KileyDA/stm32-smart-depot-safety-monitoring/images/pinout-reference/README.md

# Pinout Reference Images

This folder contains board pinout diagrams used to map Arduino header pins to STM32 microcontroller pins.
