KileyDA/stm32-smart-depot-safety-monitoring/images/circuit-diagrams/README.md

# Circuit Diagram Images

This folder contains exported circuit diagram images used in the hardware documentation.
