KileyDA/stm32-smart-depot-safety-monitoring/images/cubemx-configuration/README.md

# CubeMX Configuration Screenshots

This folder contains STM32CubeMX configuration screenshots used in the project documentation.
