KileyDA/stm32-smart-depot-safety-monitoring/images/hardware-setup/README.md

# Hardware Setup Images

This folder contains photos of the physical STM32 hardware setup and breadboard circuits.
