KileyDA/stm32-smart-depot-safety-monitoring/images/test-results/README.md

# Test Result Images

This folder contains screenshots of firmware test outputs and serial monitor results.
