KileyDA/stm32-smart-depot-safety-monitoring/images/kicad-debugging/custom-symbol-library/README.md

Contains all the screenshots for the error obtained while trying to create a custom symbol to be used in creating the PIR circuit schematic
