KileyDA/stm32-smart-depot-safety-monitoring/firmware/bare-metal-stm32f446re/Src/main.c

/**
 ******************************************************************************
 * @file           : main.c
 * @author         : Kelly Dianga
 * @brief          : Main program body
 ******************************************************************************
 * @attention
 *
 * Copyright (c) 2026 STMicroelectronics.
 * All rights reserved.
 *
 * This software is licensed under terms that can be found in the LICENSE file
 * in the root directory of this software component.
 * If no LICENSE file comes with this software, it is provided AS-IS.
 *
 ******************************************************************************
 */

#include <stdint.h>

#if !defined(__SOFT_FP__) && defined(__ARM_FP)
  #warning "FPU is not initialized, but the project is compiling for an FPU. Please initialize the FPU before use."
#endif
/* ========================
   Base addresses
   ======================== */
#define PERIPH_BASE   			  		(0x40000000UL)

#define AHB1_OFFSET	  			  		(0x00020000UL)
#define AHB1_BASE	    		  		(PERIPH_BASE + AHB1_OFFSET)

#define APB1_OFFSET				  		(0x00000000UL)
#define APB1_BASE				  		(PERIPH_BASE + APB1_OFFSET)

#define APB2_OFFSET				  		(0x00010000UL)
#define APB2_BASE				  		(PERIPH_BASE + APB2_OFFSET)

/* =========================
   Peripheral base addresses
   ========================= */
#define GPIOA_OFFSET    		  		(0x00000000UL)
#define GPIOA_BASE	  	    	  		(AHB1_BASE + GPIOA_OFFSET)

#define GPIOB_OFFSET			  		(0x00000400UL)
#define GPIOB_BASE				  		(AHB1_BASE + GPIOB_OFFSET)

#define RCC_OFFSET	    		  		(0x00003800UL)
#define RCC_BASE  	    		  		(AHB1_BASE + RCC_OFFSET)

#define TIM3_OFFSET				  		(0x00000400UL)
#define TIM3_BASE				  		(APB1_BASE + TIM3_OFFSET)

#define ADC1_OFFSET				  		(0x00002000UL)
#define ADC1_BASE				  		(APB2_BASE + ADC1_OFFSET)

#define DMA2_OFFSET						(0x00006400UL)
#define DMA2_BASE						(AHB1_BASE + DMA2_OFFSET)
/* =========================
   Register Access Helper
   ========================= */
#define REG32(addr)         	  		(*(volatile uint32_t *)(addr))

/* =========================
   RCC Register Offsets
   ========================= */
#define RCC_AHB1ENR_OFFSET        		(0x30UL)
#define RCC_APB1ENR_OFFSET        		(0x40UL)
#define RCC_APB2ENR_OFFSET        		(0x44UL)

/* =========================
   RCC Register Definitions
   ========================= */
#define RCC_AHB1ENR               		REG32(RCC_BASE + RCC_AHB1ENR_OFFSET)
#define RCC_APB1ENR               		REG32(RCC_BASE + RCC_APB1ENR_OFFSET)
#define RCC_APB2ENR               		REG32(RCC_BASE + RCC_APB2ENR_OFFSET)

/* =========================
   GPIO Register Offsets
   ========================= */
#define GPIO_MODER_OFFSET         		(0x00UL)
#define GPIO_PUPDR_OFFSET				(0x0CUL)
#define GPIO_ODR_OFFSET           		(0x14UL)
#define GPIO_IDR_OFFSET					(0x10UL)
#define GPIO_AFRL_OFFSET          		(0x20UL)

/* =========================
   GPIO Register Definitions
   ========================= */
#define GPIOA_MODER               		REG32(GPIOA_BASE + GPIO_MODER_OFFSET)
#define GPIOA_PUPDR						REG32(GPIOA_BASE + GPIO_PUPDR_OFFSET)
#define GPIOA_ODR                 		REG32(GPIOA_BASE + GPIO_ODR_OFFSET)
#define GPIOA_IDR  						REG32(GPIOA_BASE + GPIO_IDR_OFFSET)

#define GPIOB_MODER               		REG32(GPIOB_BASE + GPIO_MODER_OFFSET)
#define GPIOB_AFRL                		REG32(GPIOB_BASE + GPIO_AFRL_OFFSET)


/* =========================
   TIM3 Register Offsets
   ========================= */
#define TIM3_CR1_OFFSET          		(0x00UL)
#define TIM3_EGR_OFFSET		     		(0x14UL)
#define TIM3_CCMR1_OFFSET	     		(0x18UL)
#define TIM3_CCER_OFFSET	     		(0x20UL)
#define TIM3_CNT_OFFSET          		(0x24UL)
#define TIM3_PSC_OFFSET		     		(0x28UL)
#define TIM3_ARR_OFFSET		     		(0x2CUL)
#define TIM3_CCR1_OFFSET	     		(0x34UL)


/* =========================
   TIM3 Register Definitions
   ========================= */
#define TIM3_CR1                 		REG32(TIM3_BASE + TIM3_CR1_OFFSET)
#define TIM3_EGR                 		REG32(TIM3_BASE + TIM3_EGR_OFFSET)
#define TIM3_CCMR1               		REG32(TIM3_BASE + TIM3_CCMR1_OFFSET)
#define TIM3_CCER                		REG32(TIM3_BASE + TIM3_CCER_OFFSET)
#define TIM3_CNT                 		REG32(TIM3_BASE + TIM3_CNT_OFFSET)
#define TIM3_PSC                 		REG32(TIM3_BASE + TIM3_PSC_OFFSET)
#define TIM3_ARR                 		REG32(TIM3_BASE + TIM3_ARR_OFFSET)
#define TIM3_CCR1                		REG32(TIM3_BASE + TIM3_CCR1_OFFSET)

/* =========================
   ADC1 Register Offsets
   ========================= */
#define ADC1_SR_OFFSET          		(0x00UL)
#define ADC1_CR1_OFFSET		    		(0x04UL)
#define ADC1_CR2_OFFSET         		(0x08UL)
#define ADC1_SMPR2_OFFSET       		(0x10UL)
#define ADC1_SQR1_OFFSET	    		(0x2CUL)
#define ADC1_SQR3_OFFSET	    		(0x34UL)
#define ADC1_DR_OFFSET          		(0x4CUL)

/* =========================
   ADC1 Register Definitions
   ========================= */
#define ADC1_SR       		    		 REG32(ADC1_BASE + ADC1_SR_OFFSET)
#define ADC1_CR1		  	    		 REG32(ADC1_BASE + ADC1_CR1_OFFSET)
#define ADC1_CR2       		    		 REG32(ADC1_BASE + ADC1_CR2_OFFSET)
#define ADC1_SMPR2     		    		 REG32(ADC1_BASE + ADC1_SMPR2_OFFSET)
#define ADC1_SQR1	  		    		 REG32(ADC1_BASE + ADC1_SQR1_OFFSET)
#define ADC1_SQR3	  		    		 REG32(ADC1_BASE + ADC1_SQR3_OFFSET)
#define ADC1_DR       		   			 REG32(ADC1_BASE + ADC1_DR_OFFSET)

/* =========================
   DMA Register Offsets
   ========================= */
#define DMA_LIFCR_OFFSET				  (0x008UL)
#define DMA_S0CR_OFFSET 				  (0x010UL)
#define DMA_S0NDTR_OFFSET                 (0x014UL)
#define DMA_S0PAR_OFFSET				  (0x018UL)
#define DMA_S0M0AR_OFFSET				  (0x01CUL)

/* =========================
   DMA2 Register Definitions
   ========================= */
#define DMA2_LIFCR						  REG32(DMA2_BASE + DMA_LIFCR_OFFSET)
#define DMA2_S0CR						  REG32(DMA2_BASE + DMA_S0CR_OFFSET)
#define DMA2_S0NDTR						  REG32(DMA2_BASE + DMA_S0NDTR_OFFSET)
#define DMA2_S0PAR						  REG32(DMA2_BASE + DMA_S0PAR_OFFSET)
#define DMA2_S0M0AR						  REG32(DMA2_BASE + DMA_S0M0AR_OFFSET)

/* =========================
   RCC Peripheral Enable Bits
   ========================= */
#define GPIOAEN				   			 (1U << 0)
#define GPIOBEN				   			 (1U << 1)
#define TIM3EN				   			 (1U << 1)
#define ADC1EN				   			 (1U << 8)
#define DMA2EN						     (1U << 22)
/* =========================
   TIM3 Control Bits
   ========================= */
#define TIM_CR1_CEN     	   			 (1U << 0)
#define TIM_CR1_ARPE     	   			 (1U << 7)

/* =========================
   TIM3 Event Generation Bits
   ========================= */
#define TIM_EGR_UG             			 (1U << 0)    // Update generation


/* =========================
   TIM3 Capture/Compare Mode Bits
   ========================= */
#define TIM_CCMR1_OC1PE       			 (1U << 3)    // Output compare 1 preload enable
#define TIM_CCMR1_OC1M_PWM1   			 (0x6U << 4)  // PWM mode 1
#define TIM_CCMR1_OC1M_MASK   			 (0x7U << 4)  // OC1M bit mask
#define TIM_CCMR1_CC1S_MASK   			 (0x3U << 0)  // Channel 1 selection mask

/* =========================
   TIM3 PWM Output Bits
   ========================= */
#define TIM_CCER_CC1E   	  			 (1U << 0)

/* =========================
   GPIOB PB4 TIM3_CH1 Pin Mapping
   ========================= */
#define PB4_MODE_BIT0         			 (1U << 8)
#define PB4_MODE_BIT1         			 (1U << 9)

#define PB4_AFRL_SHIFT        			 (16U)
#define GPIO_AF2_TIM3         		 	 (0x2U)
#define GPIO_AFR_MASK         			 (0xFU)

/* =========================
   GPIOA PA0 Analog Pin Mapping
   ========================= */
#define PA0_MODE_BIT0         			 (1U << 0)
#define PA0_MODE_BIT1         			 (1U << 1)

#define ADC_SMPR2_SMP0_SHIFT  			 (0U)
#define ADC_SMPR2_SAMPLE_MASK 			 (0x7U)
#define ADC_SAMPLE_84_CYCLES  			 (0x4U)

#define ADC_SQR3_SQ1_SHIFT    			 (0U)
#define ADC_SQR3_SQ1_MASK     			 (0x1FU)
#define ADC_CHANNEL_0 		  			 (0U)

#define ADC_SQR1_LENGTH_SHIFT  			 (20U)
#define ADC_SQR1_LENGTH_MASK  			 (0xFU)
#define ADC_SEQUENCE_LENGTH_1_CONVERSION (0U)

/* =========================
   ADC Control and Status Bits
   ========================= */
#define ADC_CR2_ADON                     (1U << 0)
#define ADC_CR2_SWSTART         		 (1U << 30)
#define ADC_CR2_DMA 					 (1U << 8)
#define ADC_CR2_DDS 					 (1U << 9)
#define ADC_CR2_CONT 					 (1U << 1)
#define ADC_SR_EOC              		 (1U << 1)


/* =========================
   DMA Stream Control Bits
   ========================= */
#define DMA_SCR_EN						 (1U << 0)
#define DMA_SCR_CHSEL_MASK               (0x7U << 25)
#define DMA_SCR_DIR_MASK				 (0x3U << 6)
#define DMA_SCR_PSIZE_MASK   			 (0x3U << 11)
#define DMA_SCR_MSIZE_MASK   			 (0x3U << 13)
#define DMA_SCR_CIRC         			 (1U << 8)

#define DMA_SCR_PSIZE_HALFWORD      	 (1U << 11)
#define DMA_SCR_MSIZE_HALFWORD      	 (1U << 13)

/* =========================
   DMA Stream 0 Flag Clear Bits
   ========================= */
#define DMA_LIFCR_CLEAR_STREAM0			 ((1U<<0)|(1U<<2)|(1U<<3)|(1U<<4)|(1U<<5))

/* =========================
   Generic GPIO helpers
   ========================= */
#define GPIO_2BIT_FIELD_WIDTH      (2U)
#define GPIO_2BIT_MASK             (0x3U)

#define GPIO_PIN_SHIFT(pin)        ((pin) * GPIO_2BIT_FIELD_WIDTH)
#define GPIO_PIN_2BIT_MASK(pin)    (GPIO_2BIT_MASK << GPIO_PIN_SHIFT(pin))
#define GPIO_PIN_MASK(pin)         (1U << (pin))

#define GPIO_MODE_INPUT            (0x0U)
#define GPIO_MODE_OUTPUT           (0x1U)
#define GPIO_MODE_ALTERNATE        (0x2U)
#define GPIO_MODE_ANALOG           (0x3U)

#define GPIO_PUPD_NONE             (0x0U)
#define GPIO_PUPD_PULLUP           (0x1U)
#define GPIO_PUPD_PULLDOWN         (0x2U)

#define GPIO_SET_MODE(GPIOx_MODER, pin, mode)                  \
    do {                                                        \
        (GPIOx_MODER) &= ~GPIO_PIN_2BIT_MASK(pin);              \
        (GPIOx_MODER) |=  (((mode) & GPIO_2BIT_MASK)            \
                           << GPIO_PIN_SHIFT(pin));             \
    } while (0)

#define GPIO_SET_PUPD(GPIOx_PUPDR, pin, pupd)                  \
    do {                                                        \
        (GPIOx_PUPDR) &= ~GPIO_PIN_2BIT_MASK(pin);              \
        (GPIOx_PUPDR) |=  (((pupd) & GPIO_2BIT_MASK)            \
                           << GPIO_PIN_SHIFT(pin));             \
    } while (0)

/* =========================
   Pin Numbers
   ========================= */
#define LIGHT_DETECTOR_PIN         (0U)  // PA0
#define PIR_SENSOR_PIN             (1U)  // PA1
#define SECURITY_LIGHT_PIN         (4U)  // PB4
#define WARNING_LED_PIN            (8U)  // PA8

/* =========================
   Pin Masks
   ========================= */
#define LIGHT_DETECTOR             GPIO_PIN_MASK(LIGHT_DETECTOR_PIN)
#define PIR_SENSOR                 GPIO_PIN_MASK(PIR_SENSOR_PIN)
#define SECURITY_LIGHT             GPIO_PIN_MASK(SECURITY_LIGHT_PIN)
#define WARNING_LED                GPIO_PIN_MASK(WARNING_LED_PIN)

#define NIGHT_THRESHOLD 1200

volatile uint16_t adc_dma_value = 0;

void adc1_pa0_init(void){
	/*Enable clock for PA0*/
	RCC_AHB1ENR |= GPIOAEN;

	/*Configure PA0 as analogue*/
	GPIO_SET_MODE(GPIOA_MODER, LIGHT_DETECTOR_PIN, GPIO_MODE_ANALOG);

	/*Enable ADC peripheral clock*/
	RCC_APB2ENR |= ADC1EN;

	/*Set Sequence Length to 1 */
	ADC1_SQR1 &= ~(ADC_SQR1_LENGTH_MASK << ADC_SQR1_LENGTH_SHIFT);
	ADC1_SQR1 |= (ADC_SEQUENCE_LENGTH_1_CONVERSION << ADC_SQR1_LENGTH_SHIFT);

	/* Select ADC channel 0 as the first regular conversion */
	ADC1_SQR3 &= ~(ADC_SQR3_SQ1_MASK << ADC_SQR3_SQ1_SHIFT);
	ADC1_SQR3 |= (ADC_CHANNEL_0 << ADC_SQR3_SQ1_SHIFT);

	/*Set Sample time */
	ADC1_SMPR2 &= ~(ADC_SMPR2_SAMPLE_MASK << ADC_SMPR2_SMP0_SHIFT);
	ADC1_SMPR2 |= (ADC_SAMPLE_84_CYCLES << ADC_SMPR2_SMP0_SHIFT);

	/*Enable ADC1 */
	ADC1_CR2 |= ADC_CR2_ADON;

}

void adc1_start_conversion(void){
	/*1. Start ADC Conversion */
	ADC1_CR2 |=  ADC_CR2_SWSTART;
}

void adc1_dma_init(void){
	/* 1. Enable DMA2 clock*/
	RCC_AHB1ENR |= DMA2EN;

	/* 2. Disable DMA2 Stream 0 before configuring it.*/
	DMA2_S0CR &= ~DMA_SCR_EN;

	/* 3. Wait until DMA stream is fully disabled */
	while (DMA2_S0CR & DMA_SCR_EN) {}

	/* 4. Clear any pending flags for DMA2 Stream0 */
	DMA2_LIFCR |= DMA_LIFCR_CLEAR_STREAM0;

	/* 5. Set peripheral address: adc1 data register */
	DMA2_S0PAR = (uint32_t)&ADC1_DR;

	/* 6. Set memory address: variable where ADC result will be stored */
	DMA2_S0M0AR	= (uint32_t)&adc_dma_value;

	/* 7. Set the number of data items to transfer */
	DMA2_S0NDTR = 1;

	/* 8. Select DMA channel 0 for ADC1 */
	DMA2_S0CR &= ~DMA_SCR_CHSEL_MASK;

	/* 9. Set direction: peripheral-to-memory */
	DMA2_S0CR &= ~DMA_SCR_DIR_MASK;

	/* 10. Set peripheral data size to half-word, because ADC result is 12-bit */
	DMA2_S0CR &= ~DMA_SCR_PSIZE_MASK;
	DMA2_S0CR |= DMA_SCR_PSIZE_HALFWORD;

	/* 11. Set memory data size to half-word */
	DMA2_S0CR &= ~DMA_SCR_MSIZE_MASK;
	DMA2_S0CR |= DMA_SCR_MSIZE_HALFWORD;

	/* 12. Enable circular mode so that the value keeps updating*/
	DMA2_S0CR |= DMA_SCR_CIRC;

	/* 13. Enable DMA mode in ADC1*/
	ADC1_CR2 |= ADC_CR2_DMA;

	/* 14. Keep DMA requests active after each conversion*/
	ADC1_CR2 |= ADC_CR2_DDS;

	/* 15. Enable continous conversion mode*/
	ADC1_CR2 |= ADC_CR2_CONT;

	/* 16. Enable DMA2 Stream 0*/
	DMA2_S0CR |= DMA_SCR_EN;
}

void security_light_pwm_init(void)
{
    /* 1. Enable GPIOB clock */
    RCC_AHB1ENR |= GPIOBEN;

    /* 2. Configure PB4 as alternate function mode */
    GPIO_SET_MODE(GPIOB_MODER, SECURITY_LIGHT_PIN, GPIO_MODE_ALTERNATE);

    /* 3. Select AF2 for PB4: PB4 -> TIM3_CH1 */
    GPIOB_AFRL &= ~(GPIO_AFR_MASK << PB4_AFRL_SHIFT);  // Clear PB4 AF bits
    GPIOB_AFRL |=  (GPIO_AF2_TIM3 << PB4_AFRL_SHIFT);  // Set AF2

    /* 4. Enable TIM3 clock */
    RCC_APB1ENR |= TIM3EN;

    /* 5. Set TIM3 prescaler */
    TIM3_PSC = 160 - 1;

    /* 6. Set PWM period */
    TIM3_ARR = 100 - 1;

    /* 7. Set duty cycle */
    TIM3_CCR1 = 0;  // Security light off

    /* 8. Configure Channel 1 as PWM mode 1 */
    TIM3_CCMR1 &= ~TIM_CCMR1_CC1S_MASK;  // CC1S = 00, output mode
    TIM3_CCMR1 &= ~TIM_CCMR1_OC1M_MASK;  // Clear OC1M bits
    TIM3_CCMR1 |=  TIM_CCMR1_OC1M_PWM1;  // Set OC1M = 110, PWM mode 1

    /* 9. Enable preload for Channel 1 */
    TIM3_CCMR1 |= TIM_CCMR1_OC1PE;

    /* 10. Enable TIM3 Channel 1 output */
    TIM3_CCER |= TIM_CCER_CC1E;

    /* 11. Enable auto-reload preload */
    TIM3_CR1 |= TIM_CR1_ARPE;

    /* 12. Generate update event */
    TIM3_EGR |= TIM_EGR_UG;

    /* 13. Reset counter */
    TIM3_CNT = 0;

    /* 14. Start TIM3 */
    TIM3_CR1 |= TIM_CR1_CEN;
}

void warning_led_init(void){
    /* Enable GPIOA clock for warning LED */
    RCC_AHB1ENR |= GPIOAEN;

    /* Configure PA8 as output mode */
    GPIO_SET_MODE(GPIOA_MODER, WARNING_LED_PIN, GPIO_MODE_OUTPUT);
}

void pir_sensor_init(void)
{
    /* 1. Enable GPIOA clock */
    RCC_AHB1ENR |= GPIOAEN;

    /* 2. Configure PA1 as input mode */
    GPIO_SET_MODE(GPIOA_MODER, PIR_SENSOR_PIN, GPIO_MODE_INPUT);

    /* 3. No pull-up or pull-down for first test */
    GPIO_SET_PUPD(GPIOA_PUPDR, PIR_SENSOR_PIN, GPIO_PUPD_NONE);
}

uint8_t pir_motion_detected(void)
{
    return (GPIOA_IDR & PIR_SENSOR) != 0;
}

int main(void)
{

	security_light_pwm_init();
    warning_led_init();
    adc1_pa0_init();
    adc1_dma_init();
    adc1_start_conversion();
    pir_sensor_init();

    while (1)
    {

    	if(adc_dma_value < NIGHT_THRESHOLD){
    		/* Dark environment: keep security light dimmed - 50% brightness */
    		TIM3_CCR1 = 50;

    		if(pir_motion_detected()){
    			 /* Dark + motion detected: increase brightness and turn on warning LED */
    			TIM3_CCR1 = 100;
    			GPIOA_ODR |= WARNING_LED;
    		}
    		else{
    			 /* Dark + no motion: keep light dimmed and warning LED off */
    			TIM3_CCR1 = 50;
    			GPIOA_ODR &= ~WARNING_LED;
    		}
    	}
    	else{
    		 /* Bright environment: security light and warning LED off */
    		TIM3_CCR1 = 0;
    		GPIOA_ODR &= ~WARNING_LED;
    	}
    }
}
