KileyDA/stm32-smart-depot-safety-monitoring/(commit log)

2026-06-18 docs: add documentation for LDR voltage divider circuit
    Document the LDR voltage divider circuit for light detection, including purpose, components, pin connections, and test results.
2026-06-18 docs: create circuit diagram images folder
2026-06-18 docs: add LDR voltage divider diagram
2026-06-18 docs: move LDR documentation into circuit diagrams folder
2026-06-18 docs: add LDR physical circuit image
2026-06-18 docs: revise LDR voltage divider documentation with images
    Updated image paths and added CubeMX configuration screenshots for the LDR voltage divider circuit documentation.
2026-06-18 docs: add PIR Motion Sensor Circuit Documentation
    This document outlines the circuit design and functionality of the PIR motion sensor used in the Smart Depot Safety and Access Monitoring System, including components, pin connections, and firmware testing.
2026-06-18 docs: add PIR motion sensor test output screenshot
2026-06-18 docs: add CubeMX configuration screenshot for PIR sensor
    Added CubeMX configuration screenshot for PIR sensor input.
2026-06-19 docs: add security light PWM CubeMX screenshot
2026-06-19 docs: add warning LED CubeMX screenshot
2026-06-19 docs: add security and warning LED documentation
    Added documentation for the security light and warning LED circuits, including purpose, components, pin mapping, connections, and configuration details.
2026-06-24 docs: add active buzzer transistor driver circuit documentation
    Document the active buzzer transistor driver circuit for the Smart Depot Safety and Access Monitoring System, including purpose, components, circuit concept, and testing procedures.
2026-07-01 docs: add documentation for reset/acknowledge button circuit
    This document outlines the circuit design and functionality of the reset/acknowledge button for the Smart Depot Safety and Access Monitoring System, including its purpose, components, logic, and firmware testing.
2026-07-02 docs: add LDR voltage divider schematic
2026-07-02 chore: delete images/circuit-diagrams/01-ldr-voltage-divider.png
2026-07-02 chore: change LDR voltage divider image to schematic
    Updated the image to show the schematic of the LDR voltage divider.
2026-07-02 docs: add README with error screenshots for KiCad
    Contains all the screenshots for the error obtained while trying to create a custom symbol to be used in creating the PIR circuit schematic
2026-07-02 docs: add screenshots of errors encountered in KiCad Symbol Editor
2026-07-02 docs: add screenshot of cleared filter KiCad
2026-07-02 debugging: add KiCad symbol library troubleshooting notes
2026-07-03 docs: add PIR motion sensor schematic
2026-07-03 docs: add PIR motion sensor schematic
    Added schematic diagram for PIR motion sensor.
2026-07-03 docs: add security and warning led schematic
2026-07-03 docs: add LED schematic to security and warning LEDs documentation
    Added schematic image for security and warning LEDs.
2026-07-03 docs: add active buzzer transistor driver schematic
2026-07-03 chore: delete images/circuit-diagrams/04-active-buzzer-transistor-driver-schematic.png
2026-07-03 docs: upload correct active buzzer transistor driver schematic
2026-07-03 docs: add circuit schematic for active buzzer driver
    Added schematic image for active buzzer transistor driver circuit.
2026-07-03 docs: add reset/acknowledge button schematic
2026-07-03 docs: add circuit schematic for reset/acknowledge button
    Added a circuit schematic for the reset/acknowledge button.
2026-07-06 chore: rename circuit documentation folder
2026-07-06 docs: add folder for storing bare metal documents
    This README explains the bare-metal implementation for STM32F446RE, focusing on register-level programming without HAL functions.
2026-07-06 docs: add learning notes on RCC and clock gating
    This document provides an overview of RCC, AHB, and peripheral clock gating in STM32 microcontrollers, explaining the importance of clock signals for peripheral operation and detailing how to enable clocks for various peripherals.
2026-07-11 docs: add debugging notes for LED register assignment error
    Documented debugging notes for LED register-level code error related to assignment. Included explanation of the error, correct macro definition, and steps to resolve build issues in STM32CubeIDE.
2026-07-15 firmware: add bare-metal STM32CubeIDE project files
    Add source, startup, linker, launch, and project files for the STM32F446RE bare-metal firmware.
2026-07-15 chore: add gitignore for STM32CubeIDE build files
    Add .gitignore to exclude build artifacts and debug files.
2026-07-15 firmware: add .project file for STM32F446RE project
2026-07-15 firmware: add .cproject file for STM32F446RE project
2026-07-15 docs: add TIM3 PWM implementation notes
    This document explains the implementation of PWM for controlling a security light using TIM3 on the STM32F446RE. It covers the purpose, configuration, and setup sequence for using PWM instead of standard GPIO output.
2026-07-16 firmware: configure TIM3 PWM for security light
2026-07-16 docs: update TIM3 PWM implementation notes
    Updated the documentation to clarify the use of memory-mapped register access, improved readability with macros, and refined the setup sequence for configuring TIM3 for PWM output.
2026-07-22 docs: add ADC1 PA0 Light Detector Implementation notes
    This note details the ADC setup for reading a light detector input using ADC1 on the STM32F446RE. It covers the purpose, pin configuration, register access, initialization sequence, and integration with a security light PWM.
2026-07-22 firmware: add ADC light detection to main
    Add ADC1 PA0 setup and light threshold logic to control the security light PWM based on the LDR reading.
2026-07-27 docs: add DMA1 ADC light detector implementation Document
    Added documentation for implementing DMA with ADC1 for automatic light detection. The notes cover system context, DMA initialization, and the main flow of the program.
2026-07-27 firmware: add ADC DMA support for light detection
    Add DMA2 Stream 0 setup for ADC1 PA0 readings, enabling continuous light sensor updates through adc_dma_value and using the value to control the TIM3 PWM security light.
2026-08-17 firmware: add PIR motion detection logic
    Add PA1 PIR sensor input setup and motion detection logic. The system now uses the PIR reading together with the ADC DMA light value to control the TIM3 PWM security light: dim brightness when it is dark, full brightness when motion is detected, and off when the environment is bright.
2026-11-11 firmware: add USART2 telemetry and periodic status reporting
    Configure USART2 communication through the ST-LINK virtual COM port. Add integer and structured status transmission helpers, and implement SysTick-based 500 ms reporting of ADC readings, PIR motion, alert state, acknowledgement state and PWM brightness.
2026-11-11 docs: document STM32 serial telemetry and Python dashboard setup
    Updated README.md to provide detailed project overview, architecture, implemented features, telemetry message format, project files, setup instructions, testing, and future milestones for the Smart Depot Safety Monitoring Dashboard.
